v-kb/NixieTubeClock/Docs/Nexie_IN12_Test/Docs/Nixie_IN12.xlsx

Designator | Footprint | PartNumber | Value | Quantity
C1, C2 | 0603 |  | 10 мкФ | 2
C3, C4 | 0603 |  | 0,1 мкФ | 2
D1, D2 | 16-TSSOP | SN74HC595PW @TI |  | 2
R1, R2, R3, R4, R5, R6, R7, R8, R9, R10 | 0603 |  | 20 кОм ± 1% | 10
R11 | 2010 |  | 20 кОм ± 1% | 1
VT1, VT2, VT3, VT4, VT5, VT6, VT7, VT8, VT9, VT10 | SOT23 | MMBTA42 @DIODES |  | 10
Точность и предельное напряжение для конденсаторов подойдет любое
