v-kb/NixieTubeClock/Docs/Nexie_IN12_Test/Docs/АЦСД.687281.259-02СБ.pdf

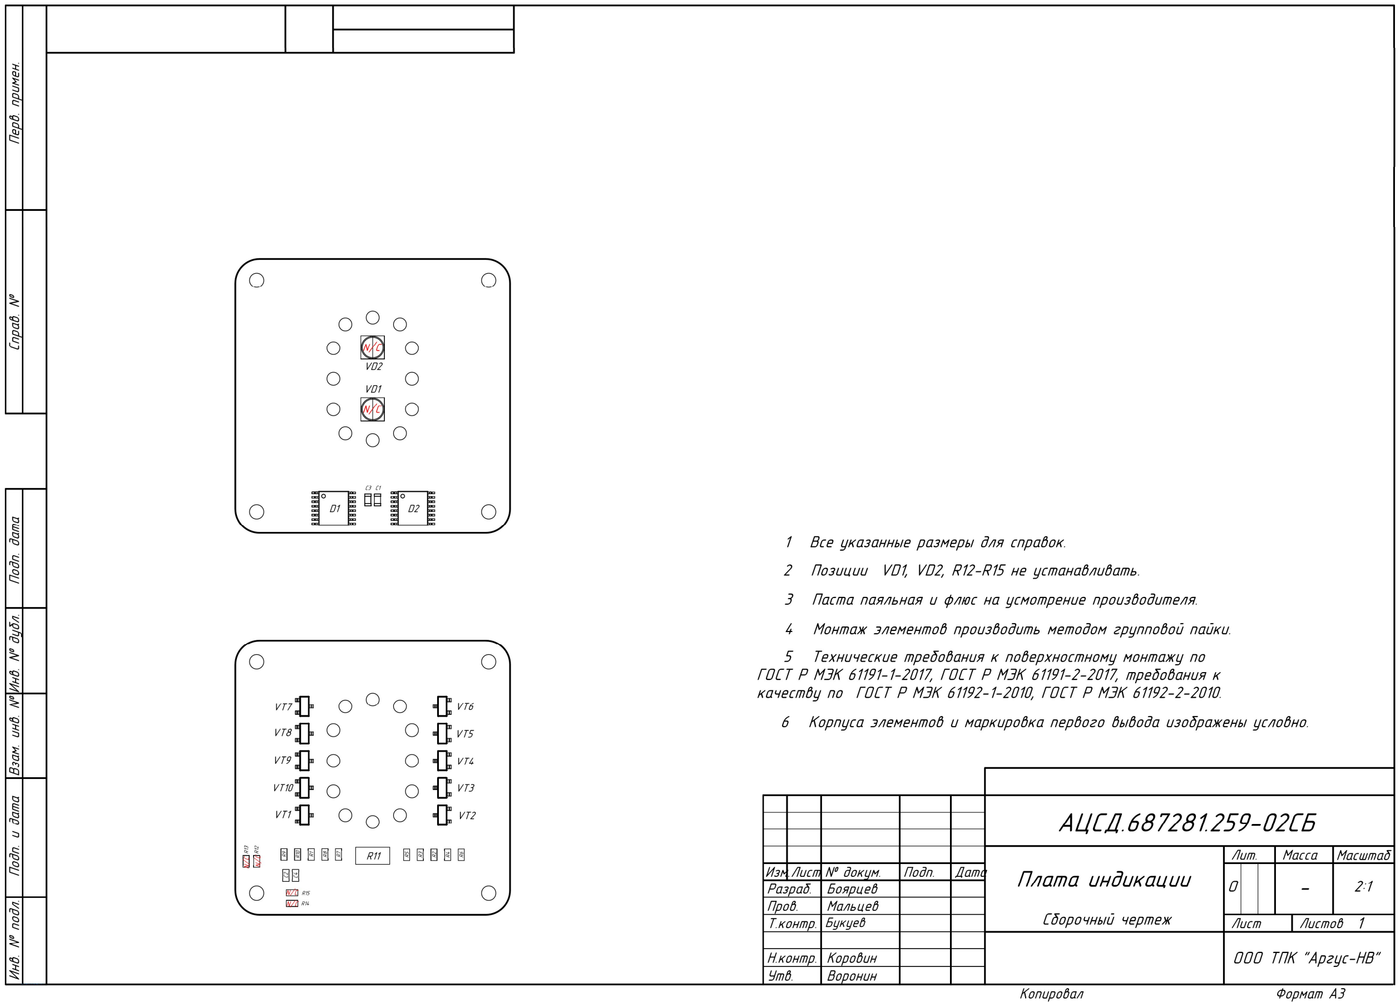
[picture p3: page 1]
