v-kb/NixieTubeClock/(threads)

Thread 1 (2024-11-05):

Понять обозначение пинов

v-kb, 2024-11-05:

v-kb, 2024-11-13:
Саша скинул примерное описалово
[Описание схемы.docx](https://github.com/user-attachments/files/17735721/default.docx)

v-kb, 2024-11-26:
| **Микроконтроллер** | **Сдвиговый регистр** | **Назначение**       |
|---------------------|-----------------------|----------------------|
| DIN                 | SER                   | Выход данных         |   |
| SCK                 | SRCLK                 | Такт.сигнал сдвига   |
| RCK                 | RCLK                  | Такт.сигнал защёлки  |

Closed 2024-11-26.

Thread 2 (2024-11-05):

Добавить базовую работу со сдвиговыми регистрами

v-kb, 2024-11-05:
- [x] #3
- [x] Поморгать светодиодами
- [x] Поморгать лампочками ИНС

v-kb, 2024-11-21:
Чтобы передать нужное число в сдвиговый регистр, мы должны:
1. Выставить низкий уровень пина Output Enable
1. Выставить самый младший бит, используя DIN (он же SER у регистра)
2. Выставить высокий уровень SRCLK (Shift Register Clock, он же SCK) - после этого регистр выставит у себя на первой ножке Qa наш младший бит. Снимаем высокий уровень с SRCLK.
3. Если нам нужно отобразить сразу изменение, то тогда ставим в высокий, а потом в низкий уровень ножку RCK (он же Storage Register).

Для работы с ИН-12 у нас та же последовательность, за исключением того, высокий уровень мы ставим лишь один раз в начале цикла и защёлку RCK мы выставляем уже после того, как сдвинули всё на нужное место.

v-kb, 2024-12-25:
Добавил функцию вывода всех 4 цифр на лампы.

Closed 2024-12-25.

Thread 3 (2024-11-26):

Создать элементарную функцию вывода цифры на определенную лампочку

v-kb, 2024-11-26:
### Вопросы
1. Какой формат в коде должен быть у данных цифры (числа из двух цифр), чтобы можно было выводить его на лампочку?
2. Как выводить:
    2.1. каким битом вперёд?
    2.2. когда дергать защёлку?

v-kb, 2024-11-26:
2.1. Решение для двух случаев:
```c
uint8_t test = 0b00000010;

// Вывод младшим битом вперёд
for (int i = 0; i<8; ++i) printf("%d", (test >> i)&1);

printf("\n");

// Вывод старшим вперёд
for (int i = 7; i>=0; --i) printf("%d", (test >> i)&1);
```
Результаты
01000000
00000010

v-kb, 2024-12-25:
Выводить надо оказалось старшим битом вперёд, и все 16 бит (у нас используется 10 бит для цифры).
Реальный код:
```c
for (int8_t bit = 15; bit >= 0; --bit) {
	DATA_SET((data >> bit) & 1);					// Send least significant bit first
	shift_reg_pulse_srclk(PULSE_DURATION_MS);
}
```

v-kb, 2024-12-25:
> 2.2. когда дергать защёлку?

Когда сдвинули все 4*16 бит на место, то есть вывели все 4 цифры на лампы. После этого надо включить выход OE, чтобы они загорелись.

Closed 2024-12-25.

Thread 4 (2024-12-25):

Запоминание текущего времени и даты

v-kb, 2024-12-25:
Нужно при включении подтягивать время и дату из микросхемы которая в себе считает время.

v-kb, 2024-12-25:
Добавил проверку на ненулевые значений времени - если часы, минуты и секунды равны нулям, то мы должны выставить предустановленные значения.
Но, пожалуй, лучше стоит переделать на проверку того, включен ли осциллятор микросхемы счета. Включен - значит она работала до включения микроконтроллера и что-то считала.

Closed 2025-01-10.

Thread 6 (2024-12-25):

Добавить настройку времени с помощью кнопок

v-kb, 2024-12-25:
Это будет происходить в обычном режиме работы, потому что это самая базовая функция для настройки часов.
Логика работы такая:
Первая кнопка была зажата больше 3 секунд -> начинают мигать часы (первая пара цифр) -> настраиваем двумя другими кнопками + и - часы -> Начинает мигать вторая пара (минуты) -> настроили их -> время смещается слево, чтобы стало видно секунды (по дефолту они = 0) -> настройка на этом завершается, время начинает нормальный отсчёт.

v-kb, 2025-01-10:
Более неактуальна в данном виде, так как разработан план работы меню в #7

Closed 2025-01-10.

Thread 7 (2024-12-25):

Выбор режима работы

v-kb, 2024-12-25:
По комбинации нажатия кнопок мы должны переходить в режим настройки. Требования:
1. Первая пара чисел должна указывать пункт меню в котором мы находимся
2. Двоеточие/красная подсветка/моргание числа должны показывать сохранена данная настройка или нет
3. Вторая пара чисел отвечает за значение настройки

v-kb, 2025-01-09:
Управление, пожалуй, сделаю следующим:
1. Если мы в "главном меню" (показывается время или что-то ещё), то влево или вправо будут переключать показываемые данные, например, чтобы можно было посмотреть дату и потом год двигаясь "вправо" (по нажатию на правую клавишу то еть) и текущую температуру и далее день недели.
2. Чтобы переходить между рабочим режимом и настройками нужно в главном меню - нажать (или удерживать) ввод, а чтобы выйти обратно - удерживать ввод.
4. Краткое нажатие ввод в режиме настроек будет переключать выбор с пункта меню на значение и обратно.
5. Долгое нажатие в главном режиме также перебросит в настройки.
6. Чтобы сбросить показываемый сейчас пункт меню, нужно удерживать Л+П.
7. Чтобы сбросить все настройки разом - удерживать Л+П+Ц.

v-kb, 2025-01-17:
Добавил по крайней мере перемещение по первому уровню меню (показ основных функций) и подстройку минут и часов с выделением изменяемого числа яркостью цифр.

v-kb, 2025-01-28:
Короткое нажатие по кнопке Ц (центральная) включает-отключает показ всего (спящий режим).

v-kb, 2025-01-28:
- [ ] Автоматический возврат к показу HH:MM;
- [ ] Настройка времени и даты в именно настройках, в первом пункте
- [ ] Настройка яркости: либо по датчику, либо пользовательская
- [ ] Показ пункта меню будет занимать все цифры, так же как и значение параметра

Пункты меню:
1. Настройка времени, даты, года
2. Настройка яркости (фикс.)
3. Включение/выключение автоматической регулировки
4. Цвет и яркость подсветки (цвет и яркость)
5. Таймер/настройка времени работы
6. Выбор анимации смены цифр

v-kb, 2025-01-28:
В первую очередь сделать выключение/включение по кнопке, датчик температуры, убрать показ версии и даты прошивки.

v-kb, 2025-02-13:
Ещё идея:
В функциях изменения чего-то мы будем менять машину состояний, в которую будут передаваться такие параметры как:
- Данные для вывода
- Формат вывода
- Тип анимации
- Состояние анимации

Вся эта машина будет крутиться в фоне для автоматического изменения того, что мы показываем.
А также должен быть менеджер того, какие функции когда вызывать - и они в свою очередь будут менять состояния.

Thread 8 (2024-12-25):

Способ контроля цифр по отдельности

v-kb, 2024-12-25:
Мы должны уметь указывать для конкретной лампы такие параметры как:
1. Вкл или выкл
2. Яркость (через псевдо-ШИМ)

То есть будет некая структура, где мы будем хранить эти параметры.
И функция отображения цифр будет брать эти параметры и подстраивать в каждый отдельный момент времени свои внутренние параметры , чтобы достичь необходимой "картинки".
Например, внутри такой функции будут некие переменные/счетчики, отвечающие за текущее состояние цифр:
- период ШИМ
- включить или выключить цифру

На основании этого будет составляться "картина" уже из атомарных базовых функций управления лампами.

Возможно, стоит переделать это уже сейчас для работы с freertos

v-kb, 2025-01-09:
Было решено сделать ШИМ с помощью таймера 2 и его 4х каналов ШИМ настроенных без выхода + DMA для удобной регулировки широты импульса.
Такое решение позволяет менять широту импульса у каждой лампы по отдельности (можно управлять яркостью конкретной лампы) и асинхронно (в разное время) друг от друга.

Closed 2025-01-09.

Thread 13 (2025-01-21):

Настройка "окна" работы

v-kb, 2025-01-21:
Например, чтобы они ночью, когда никого нет в кабинете, они не светились и не тратили ресурс ламп. Или же возможность приглушать яркость в этот момент.

Thread 16 (2025-02-05):

Переделать управление

v-kb, 2025-02-05:
Можно сделать упраление сдвиговым регистром через таймер + DMA + bit-banding, отправляя по этой цепочке бистрим в регистр управление выводом ножек.
Для этого необходимо обновлять битстрим при каждом изменении цифр.

Thread 17 (2025-02-13):

Идеи для реализации

v-kb, 2025-02-13:
Можно накидывать совершенно любые идеи - тут будет ветка для всех. Обсуждение по каждому конкретному будет вестись в своих отдельных задачах (если будут иметь продолжение).

v-kb, 2025-02-13:
Пришла интересная мысль: если уметь управлять каждой цифрой в каждой лампе, то можно отображать сразу 2, 3... и т.д.
Интересует возможность отображать две - с их помощью можно сделать простой калькулятор-сумматор.
1. Оба числа отображаются вместе
2. Выбор числа для редактирования индицируется двоеточием: мигает верхняя точка, значит редактируется первое; мигает вторая - редактируется второе. И горят как-то ещё когда смотрим результат)
3. Если результат получается больше 4х знаков, то мы можем применить анимацию "бегущей строки", показывая попеременно то начало, то конец числа.
4. Та же бегущая строка применима и к редактированию чисел.

Вряд ли кому-то нужен _калькулятор_ в _часах_, но подумал, что это очень забавная фишка, которую можно попробовать для себя как-нибудь реализовать.

v-kb, 2025-02-14:
### Идея
Сделать показ температуры по маху рукой перед часами. Будет работать засчёт датчика освещения - кратковременное и резкое уменьшение падающего света будет вызывать временный показ данных.

v-kb, 2025-02-14:
### Вопрос
Стоит ли делать у цифр разную яркость в зависимости от положения в лампе?

> 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
