v-kb/NixieTubeClock/(list of files, drawings)

Other design files:
Docs/Nexie_IN12_Test/Nixie_IN12.PrjPcb
Docs/Nexie_IN12_Test/Nixie_IN12.SchDoc
Docs/PCB/Nixie_MCU.PrjPcb
Docs/PCB/Nixie_MCU.SchDoc
Docs/PCB/Nixie_MCU_PWR.SchDoc
