v-kb/NixieTubeClock/Core/Src/main.c

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
/* Includes ------------------------------------------------------------------*/
#include "main.h"

/* USER CODE BEGIN Includes */
#include "nixie_tubes.h"
#include "menu.h"
#include "buttons.h"
#include "settings.h"
#include "temperature_sensor.h"
#include "opt3001.h"
/* USER CODE END Includes */

I2C_HandleTypeDef hi2c1;

UART_HandleTypeDef hlpuart1;
UART_HandleTypeDef huart2;

TIM_HandleTypeDef htim2;
TIM_HandleTypeDef htim21;
DMA_HandleTypeDef hdma_tim2_ch1;
DMA_HandleTypeDef hdma_tim2_ch2;
DMA_HandleTypeDef hdma_tim2_ch3;
DMA_HandleTypeDef hdma_tim2_ch4;

/* USER CODE BEGIN PV */
//extern RTC_TimeTypeDef 	rtc_time;
Buttons_HandleTypeDef 	hbtns;
volatile float t = 0;
volatile float lux = 0;
Button_InitTypeDef btns_list[] = {
		{BTN_1_GPIO_Port, BTN_1_Pin, GPIO_PIN_RESET},
		{BTN_2_GPIO_Port, BTN_2_Pin, GPIO_PIN_RESET},
		{BTN_3_GPIO_Port, BTN_3_Pin, GPIO_PIN_RESET},
};
Setting_TypeDef s_ptr[] = {
// 		Name				Current value	  Default	Delta	  Min		Max				Need to save		  Cyclic change
		{"BRIGHTNESS",				.val = 0, .def = 0, .del = 0, .min = 0, . max = 0, 		.is_need_to_save = 1, .is_change_cyclic = 0},
		{"AMBIENT_LIGHT_SENSOR",	.val = 0, .def = 1, .del = 1, .min = 0, . max = 1, 		.is_need_to_save = 1, .is_change_cyclic = 1},
		{"TEMPERATURE_SENSOR",		.val = 0, .def = 1, .del = 1, .min = 0, . max = 1, 		.is_need_to_save = 1, .is_change_cyclic = 1},
};

//Item_TypeDef nixie_items[NUM_ITEMS] = {
//		[ITEM_DISP_YEAR] 				= {.data_get = (void*)DS3231_GetSecond, .format = "%4d", 		.child = &nixie_items[ITEM_SETTING_DATE_TIME]},
//		[ITEM_DISP_DAY_MONTH] 			= {.data_get = (void*)GetDayMonth, 		.format = "%02d%02d", 	.child = &nixie_items[ITEM_SETTING_DATE_TIME]},
//		[ITEM_DISP_MINUTES_SECONDS] 	= {.data_get = (void*)GetDayMonth, 		.format = "%02d%02d", 	.child = &nixie_items[ITEM_SETTING_DATE_TIME]},
//		[ITEM_DISP_TEMPERATURE] 		= {.data_get = (void*)GetDayMonth, 		.format = "%2.2f", 		.child = &nixie_items[ITEM_SETTING_DATE_TIME]},
//
//		[ITEM_DISP_TEMPERATURE] 		= {.data_get = (void*)GetDayMonth, 		.format = "%2.2f", 		.child = &nixie_items[ITEM_SETTING_DATE_TIME]},
//};
//
//Item_TypeDef* items_main[] = {
//		{.menu = NO_MENU, 	.s_ptr = NULL, 			.numbers = {0, 0}}, 	// "NO_ITEM",
//		//		{.menu = MAIN, 		.s_ptr = NULL, 			.numbers = {0, 5}}, 	// "FW VERSION",
//		//		{.menu = MAIN, 		.s_ptr = NULL, 			.numbers = {22, 05}}, 	// "COMPILE DATE",
//		{.menu = MAIN, 		.s_ptr = NULL, 			.numbers = {20, 25}}, 	// "YEAR",
//		{.menu = MAIN, 		.s_ptr = NULL, 			.numbers = {31, 01}}, 	// "DAY_MONTH",
//		{.menu = MAIN, 		.s_ptr = NULL, 			.numbers = {99, 99}}, 	// "HOURS_MINUTES",
//		{.menu = MAIN, 		.s_ptr = NULL, 			.numbers = {8, 30}}, 	// "MINUTES_SECONDS",
//		{.menu = MAIN, 		.s_ptr = NULL, 			.numbers = {25, 3}},		// Temperature
//		{.menu = SETTINGS, 	.s_ptr = &s_ptr[0], 	.numbers = {1, 3}},
//		{.menu = SETTINGS, 	.s_ptr = &s_ptr[1], 	.numbers = {2, 4}},
//		{.menu = SETTINGS, 	.s_ptr = &s_ptr[2], 	.numbers = {3, 5}},
//		//		item_brightness, // "TUBES BRIGHTNESS ADJUST",
//		//		item_ambient_light_sensor, // "AMBIENT LIGHT SENSOR",
//		//		item_temperature_sensor, // "TEMPERATURE SENSOR",
//		//		{.menu = SETTINGS, 	.s_ptr = NULL, .numbers = {4, 6}}, // "BLUETOOTH",
//};
//uint16_t settings_size = sizeof(s_ptr)/sizeof(s_ptr[0]);
//uint8_t num_of_btns = sizeof(btns_list)/sizeof(btns_list[0]);
//uint8_t num_of_items = sizeof(items_list)/sizeof(items_list[0]);







NixieClock hclock;

/* USER CODE END PV */

void SystemClock_Config(void);
static void MX_GPIO_Init(void);
static void MX_DMA_Init(void);
static void MX_I2C1_Init(void);
static void MX_LPUART1_UART_Init(void);
static void MX_USART2_UART_Init(void);
static void MX_TIM21_Init(void);
static void MX_TIM2_Init(void);
/**
  * @brief  The application entry point.
  * @retval int
  */
int main(void)
{
  /* MCU Configuration--------------------------------------------------------*/

  /* Reset of all peripherals, Initializes the Flash interface and the Systick. */
  HAL_Init();

  /* Configure the system clock */
  SystemClock_Config();

  /* Initialize all configured peripherals */
  MX_GPIO_Init();
  MX_DMA_Init();
  MX_I2C1_Init();
  MX_LPUART1_UART_Init();
  MX_USART2_UART_Init();
  MX_TIM21_Init();
  MX_TIM2_Init();
  /* USER CODE BEGIN 2 */
	settings_init(s_ptr, 3);
	IN12_init();
	DS3231_Init(&hi2c1);
//	init_menu_items(&hmenu, items_list, NUM_OF_MENUS, NUM_OF_ITEMS);
	btns_init(&hbtns, btns_list, 3, &htim21, PRESSED);
	Tmp75_Init(&hi2c1);
	opt3001_init();

  /* USER CODE END 2 */

  /* Infinite loop */
  /* USER CODE BEGIN WHILE */
	// 7-15 Volts input

	// No need to fix interrupt being called right after the starting timer
	// Here it serve the purpose of updating important variables and setting bits in control registers
	while (1)
	{
		if(logic[current_item][shared_mask][shared_press_type] != NULL) {
			(*logic[current_item][shared_mask][shared_press_type])();
			shared_mask = 0;
			shared_press_type = 0;
		}

    /* USER CODE END WHILE */

    /* USER CODE BEGIN 3 */
	}
  /* USER CODE END 3 */
}

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
