v-kb/NixieTubeClock/(commit log)

2024-11-13 Added datasheets, added RTC, did simple blink in main
    [Nixie_IN12.PrjPcb, Nixie_IN12.SchDoc, Nixie_IN12.xlsx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]
2024-12-01 Fixed shift register operation, added DS3231 lib
    [main.c]
2024-12-26 Added buttons functions
2024-12-28 Added basic (for all digits) PWM
2025-01-09 Added brightness control for individual tubes
2025-01-09 Added other PWM channels
2025-01-09 Added output compare to button timer
2025-01-31 Added temperature sensor, enabled changing of YYYY, MM, and DD
2025-02-03 Added optic sensor library
